MetallDustin/Maoam-Automat/(commit log)

2026-11-02 Add Raspberry Pi installation script
2026-11-02 Prevent unsafe referrer redirects
    [automaten_server.py]
2026-11-03 Add prototype photos to documentation
